eganbauersfeld/striketoo/assets/images/Bearge Photos/gauntlet-v1.jpg.png

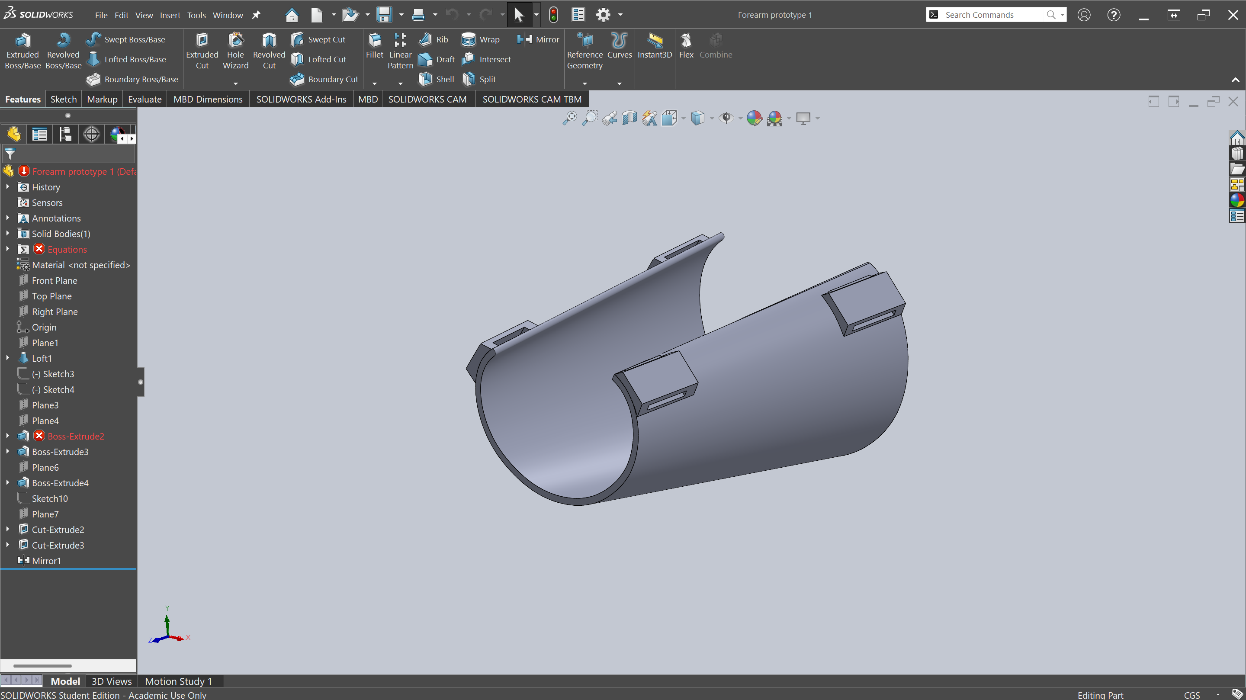
assets/images/Bearge Photos/gauntlet-v1.jpg.png
