eganbauersfeld/striketoo/assets/images/Bearge Photos/mission-image.webp

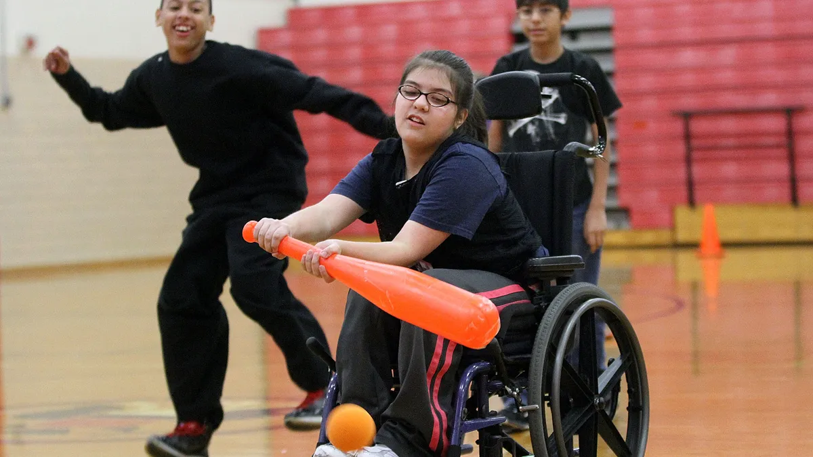
assets/images/Bearge Photos/mission-image.webp
