eganbauersfeld/striketoo/assets/images/Bearge Photos/racket-hero.jpg

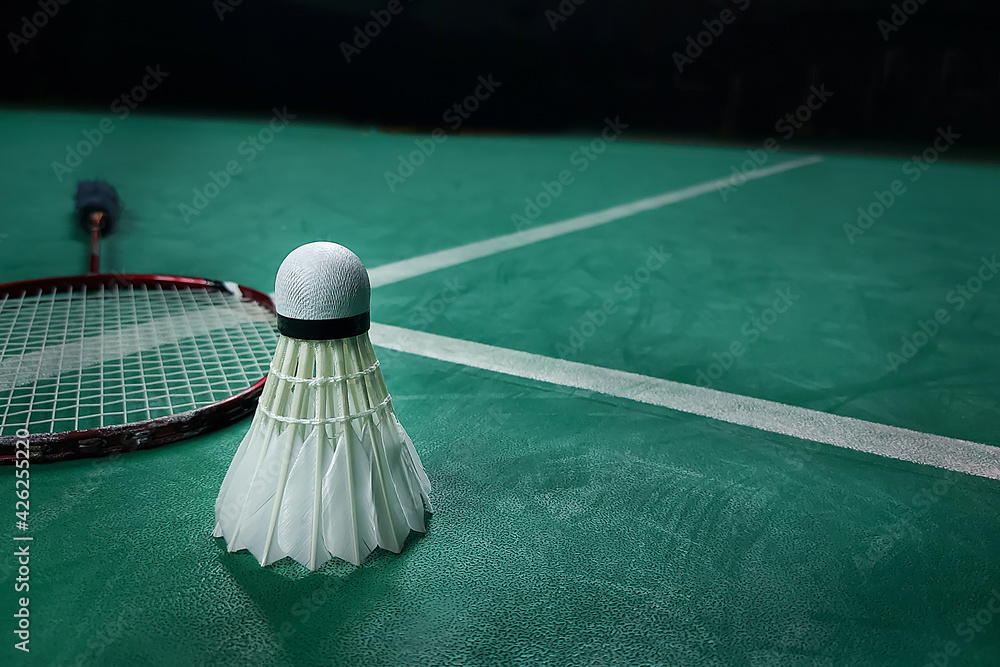
assets/images/Bearge Photos/racket-hero.jpg
