eganbauersfeld/striketoo/assets/images/sarah-brockberg.jpg

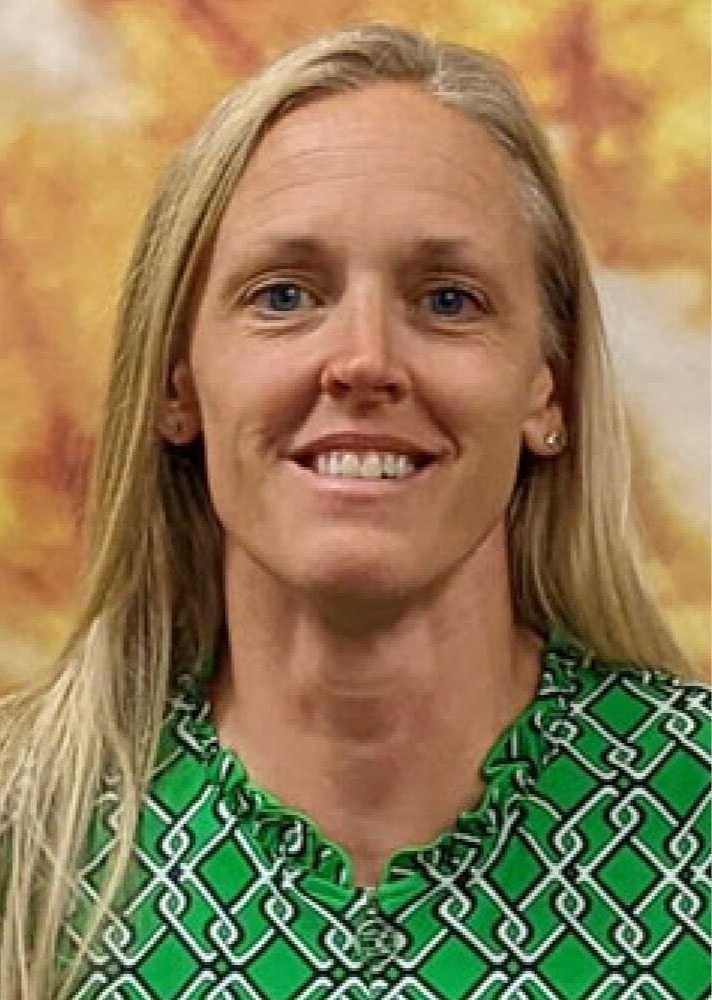
assets/images/sarah-brockberg.jpg
