eganbauersfeld/striketoo/assets/images/GripAttachmentV2.STL

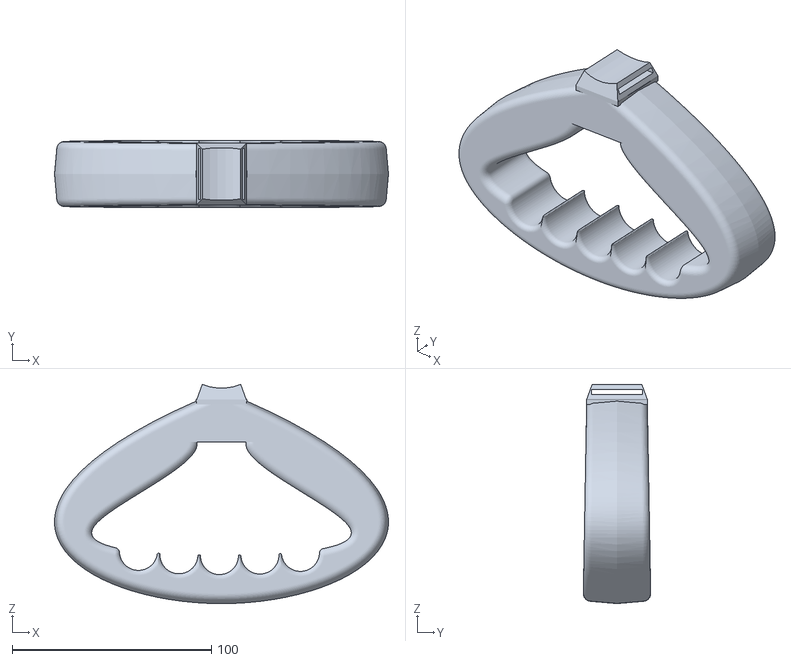
[picture p5: CAD file, 2026-04-16]
assets/images/GripAttachmentV2.STL
167.6 x 33.8 x 110.0
