eganbauersfeld/striketoo/assets/images/StrikeTooClosed.STL

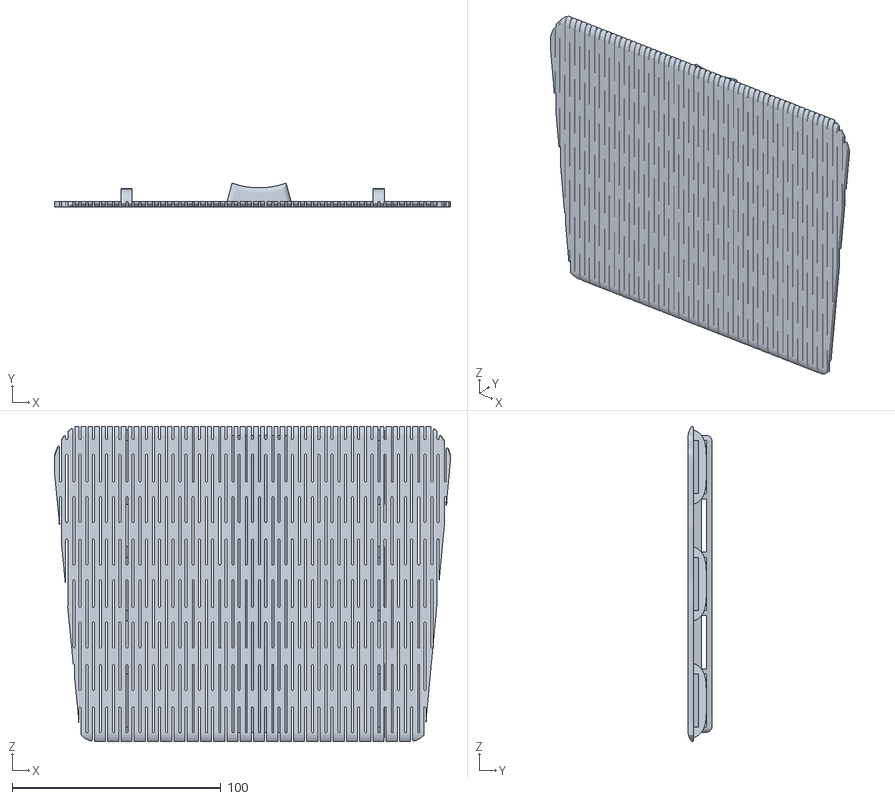
[picture p6: CAD file, 2026-04-16]
assets/images/StrikeTooClosed.STL
189.5 x 11.4 x 150.8
