eganbauersfeld/striketoo/(commit log)

2026-02-28 Expand prototype feedback content for design review checklist
2026-04-16 Add Prototype 2 MVP field test section to prototypes page
2026-04-16 Update assembly efficiency to validated (~5 min/unit)
2026-04-16 Add Print Guide page with step-by-step instructions and nav update
2026-04-16 Add StrikeTooClosed STL and render image to print guide
    [StrikeTooClosed.STL]
2026-04-16 Remove neoprene padding from print guide materials and steps
2026-04-16 Add optional Grip Attachment V2 section to print guide
    [GripAttachmentV2.STL]
